0xrphl/Solar-crypto-mining-farm-maximization-control/Miner_solar_cluster_imgs/README.md

# 📸 Project Photo Gallery

All hardware photos, product screenshots, and installation images for the Solar Mining Cluster project.

---

## 🏠 House & Solar Installation

| | |
|---|---|
| House Front | House Isometric |

## ⚡ Distribution Panel & Circuit

| | |
|---|---|
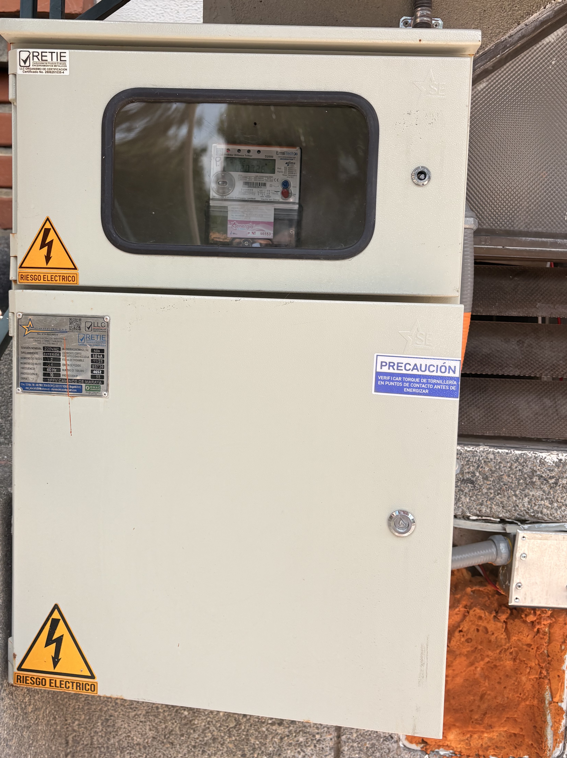
[picture p32: Miner_solar_cluster_imgs/electrical outdoor panel closed.jpeg]
Panel Closed
|  | Panel Open |
| Panel Close-up | Circuit Diagram |
| Hand-drawn Circuit | Item List |

## 🧠 ESP32-S3 Controller (LilyGO T-Display-S3)

| | | |
|---|---|---|
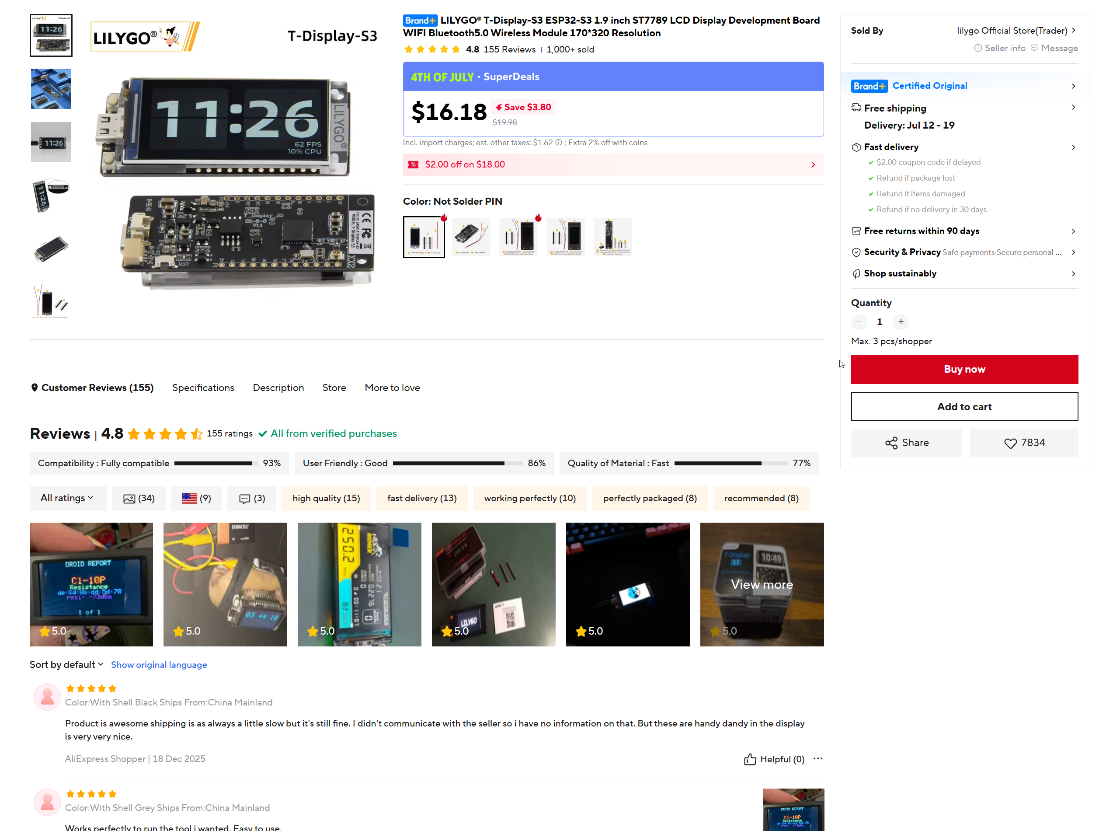
[picture p33: Miner_solar_cluster_imgs/LILYGO T-Display-S3 ESP32-S3 1.9 inch ST7789 aliexpress screenshot.png]
AliExpress
|  | Front | Back |
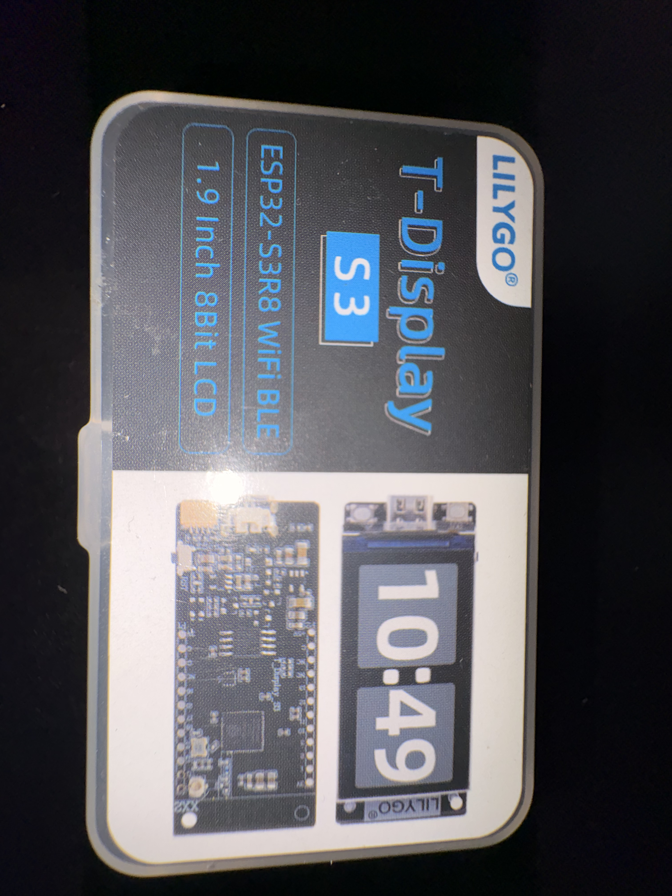
[picture p34: Miner_solar_cluster_imgs/LILYGO® T-Display-S3 ESP32-S3 box front.jpeg]
|  | | |

## 📊 Refoss EM06P Energy Monitor

| | | |
|---|---|---|
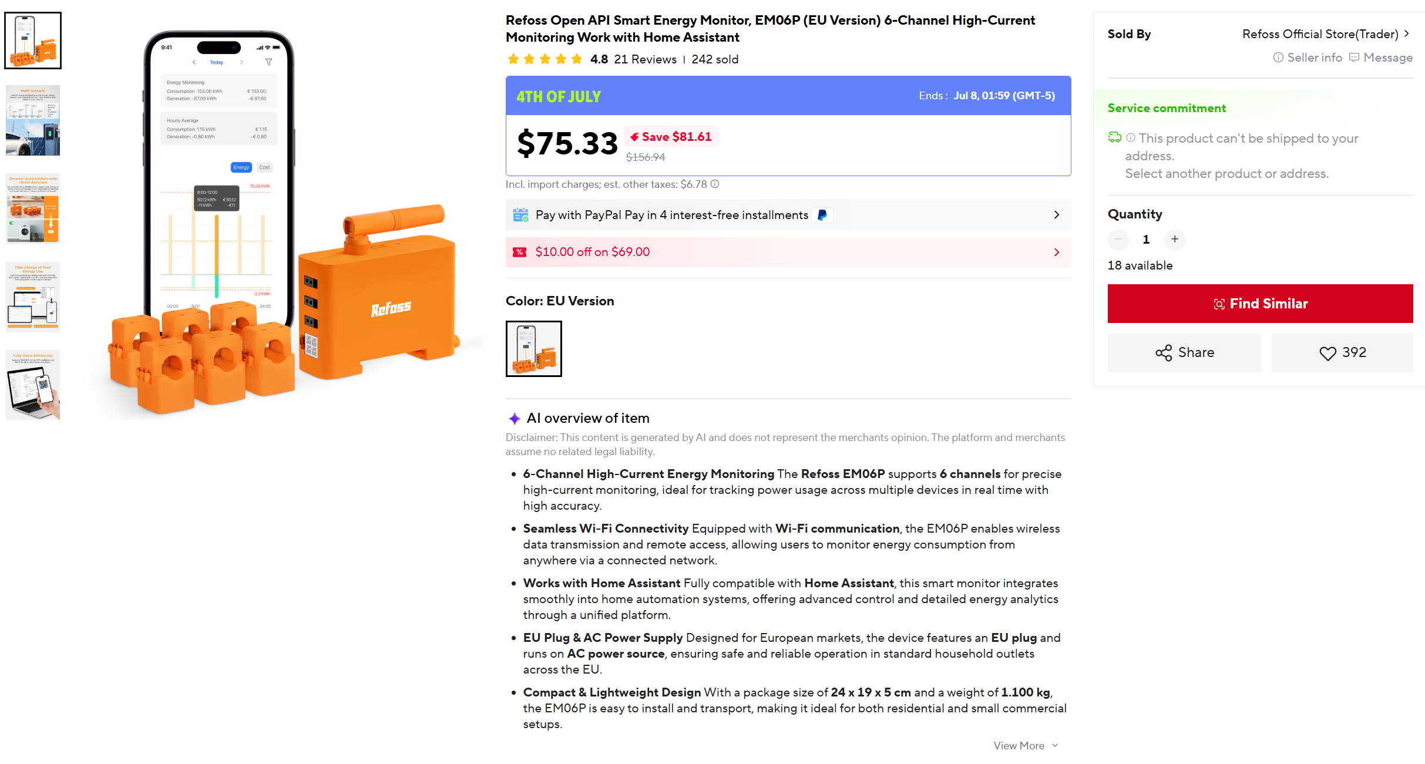
[picture p35: Miner_solar_cluster_imgs/Refoss EM06P 6-Channel WiFi Energy Monitor EU Aliexpress.png]
AliExpress
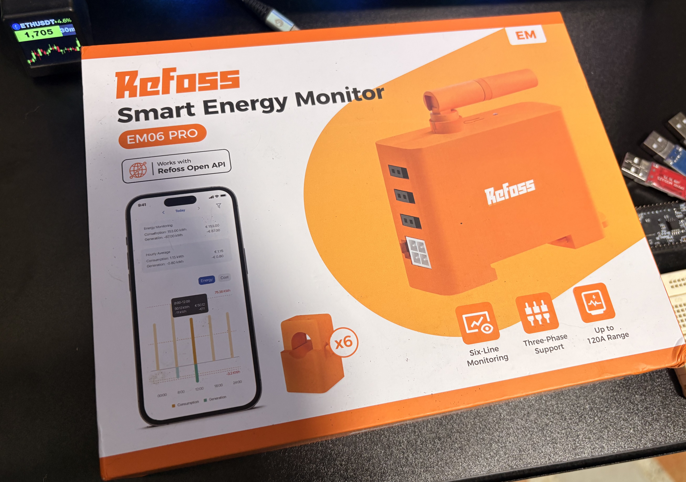
[picture p36: Miner_solar_cluster_imgs/Refoss Open API Smart Energy Monitor, EM06P (EU Version) 6-Channel High-Current Monitoring Work with Home Assistant box.jpeg]
|  |  | Open Box |
| Crimping | Terminals | |

## 🔌 Relay Boards

### ESP32-WROOM 2CH Relay (Active — 192.168.1.78)

| | | |
|---|---|---|
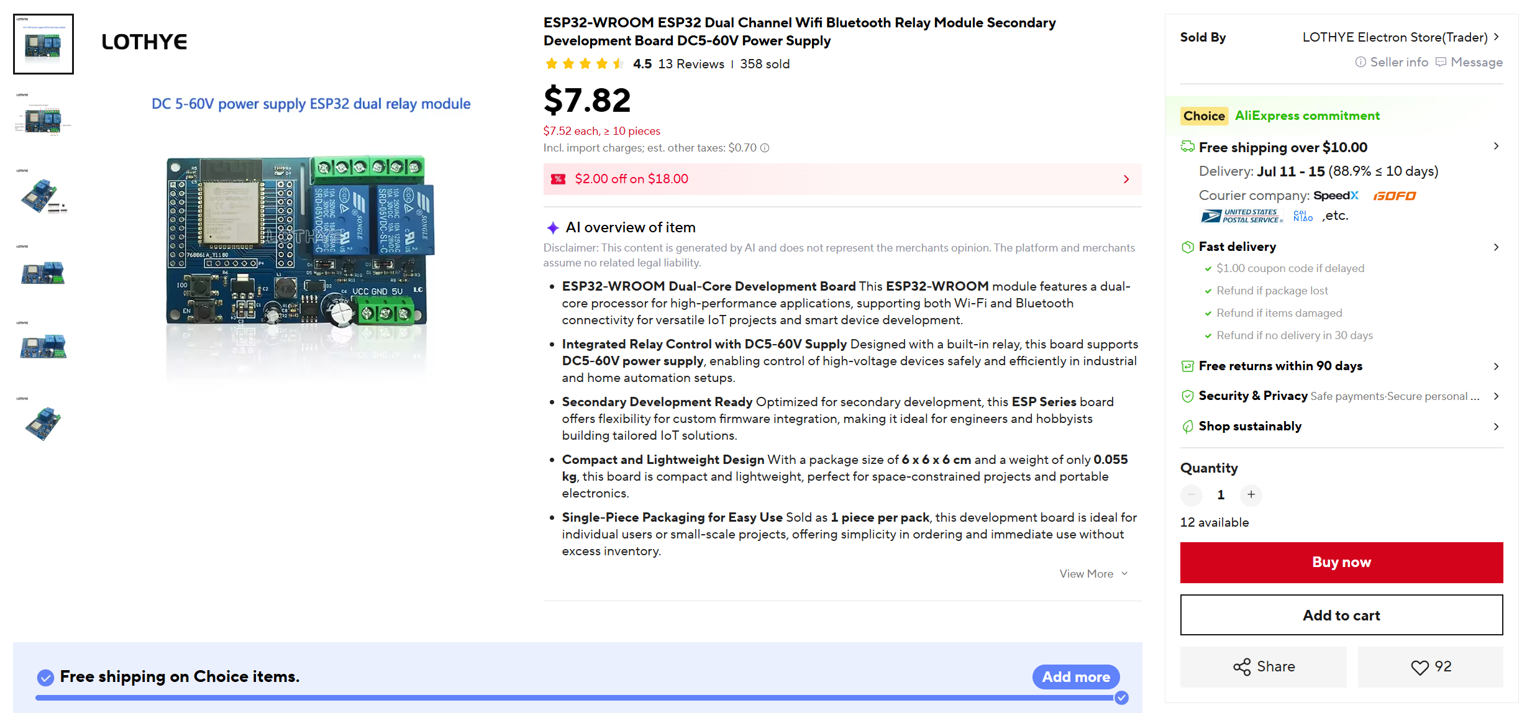
[picture p37: Miner_solar_cluster_imgs/ESP32-WROOM ESP32 Dual Channel Wifi Bluetooth Relay Module Secondary Development Aliexpress.png]
AliExpress
Back
|  | Front |  |
| Installed | Connected | |

### ESP8266 2CH 30A Relay (Backup — 192.168.1.77)

| | |
|---|---|
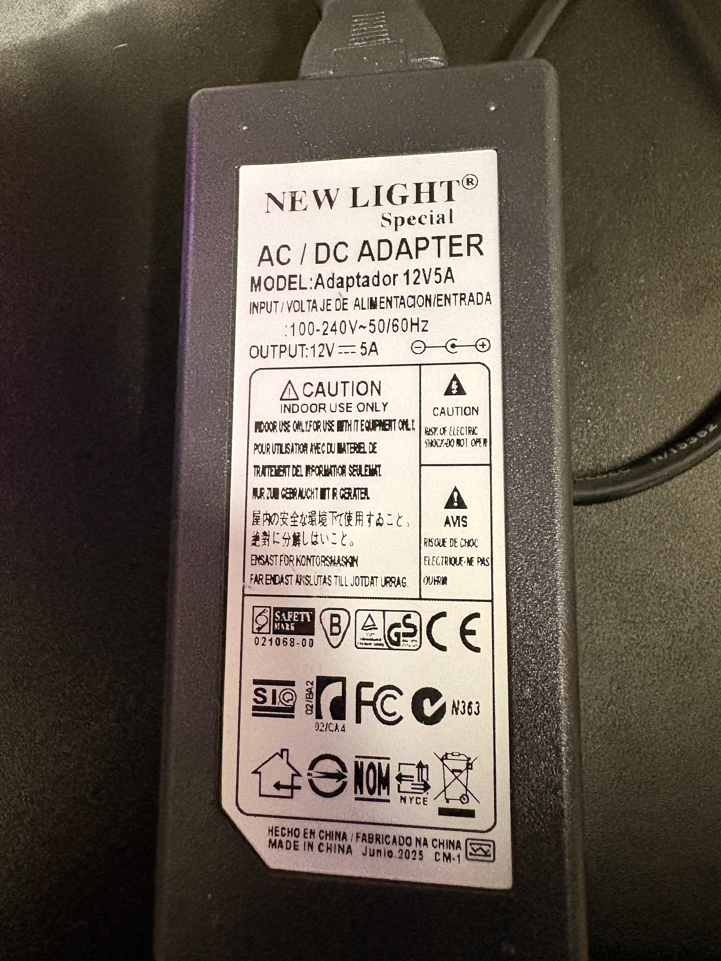
[picture p39: Miner_solar_cluster_imgs/ESP8266 2relay PSU.jpeg]
PSU
| AliExpress |  |

## ⛏️ Mining Hardware

### BitAxe Gamma 601 (1.5 TH/s, 21W)

| | |
|---|---|
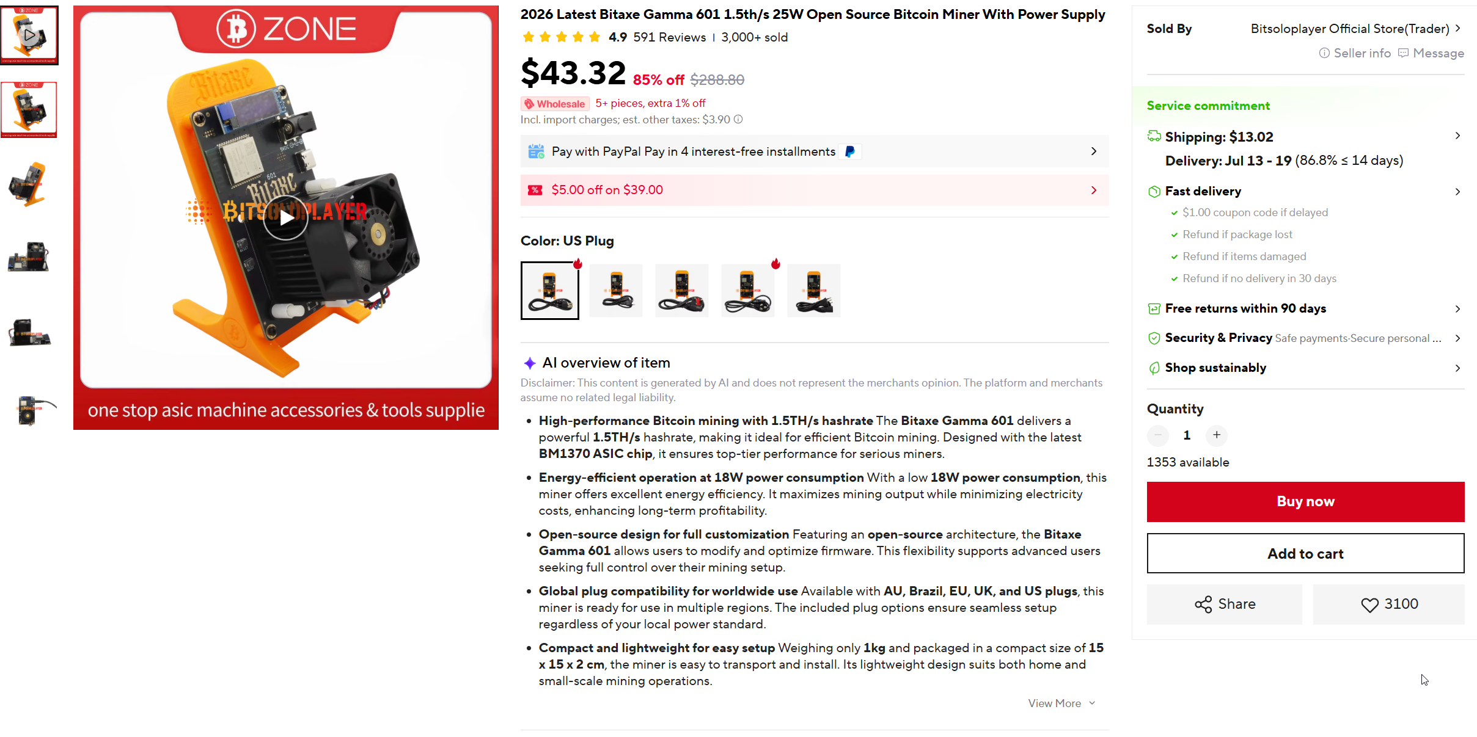
[picture p40: Miner_solar_cluster_imgs/Bitaxe Gamma 601 1.5TH Bitcoin Miner 25W Aliexpress.png]
AliExpress
|  | Front |

### NerdQAxe+ (2.5 TH/s, 60W)

| | |
|---|---|
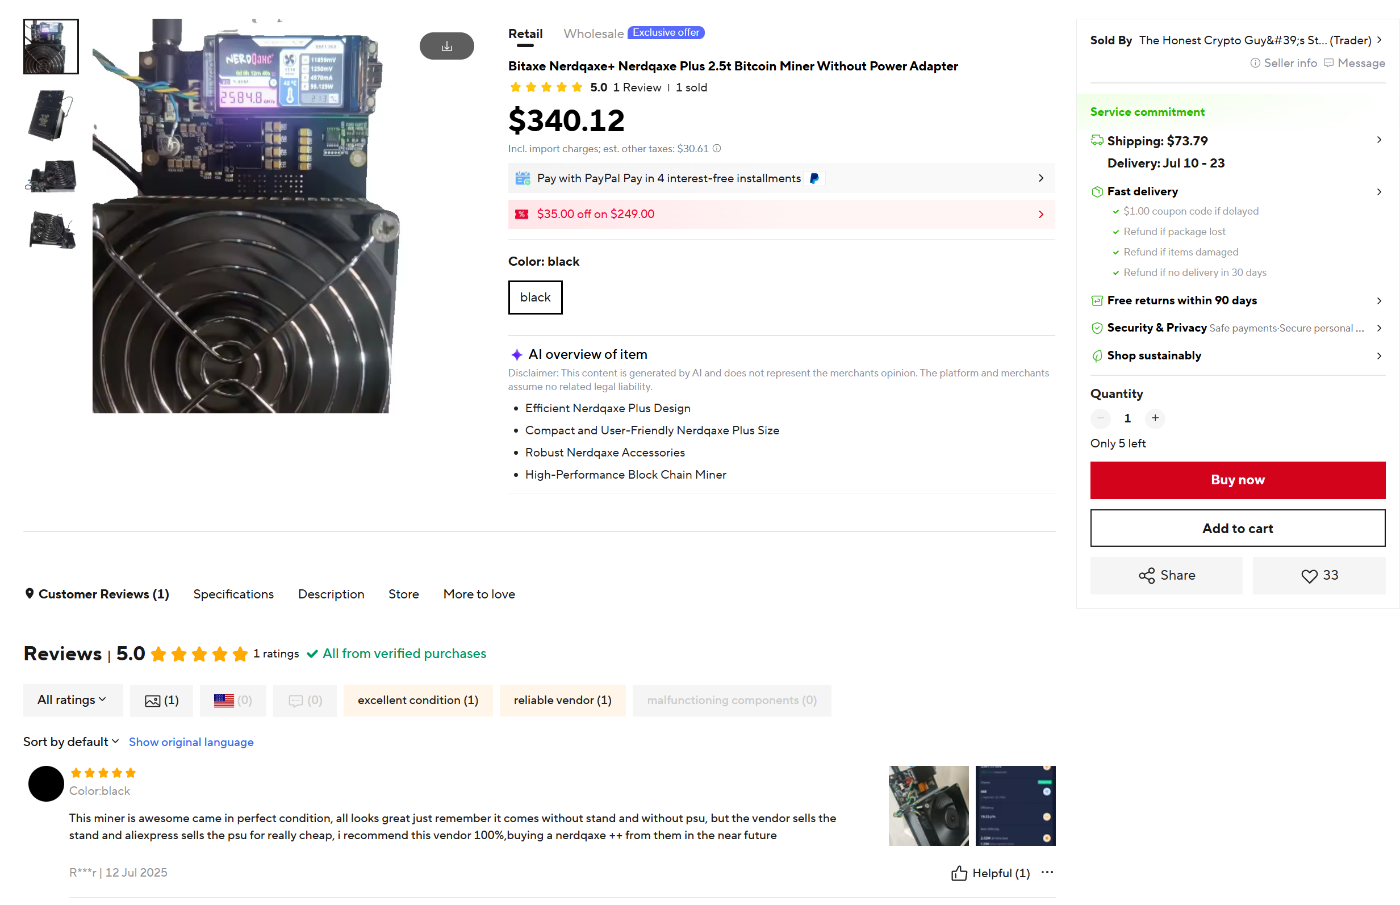
[picture p41: Miner_solar_cluster_imgs/Bitaxe Nerdqaxe+ Nerdqaxe Plus 2.5t Bitcoin Miner Without Power Adapter - AliExpress.png]
AliExpress
|  | Cluster |

### Nerd Octaxe (10.7 TH/s, 180W)

| | | |
|---|---|---|
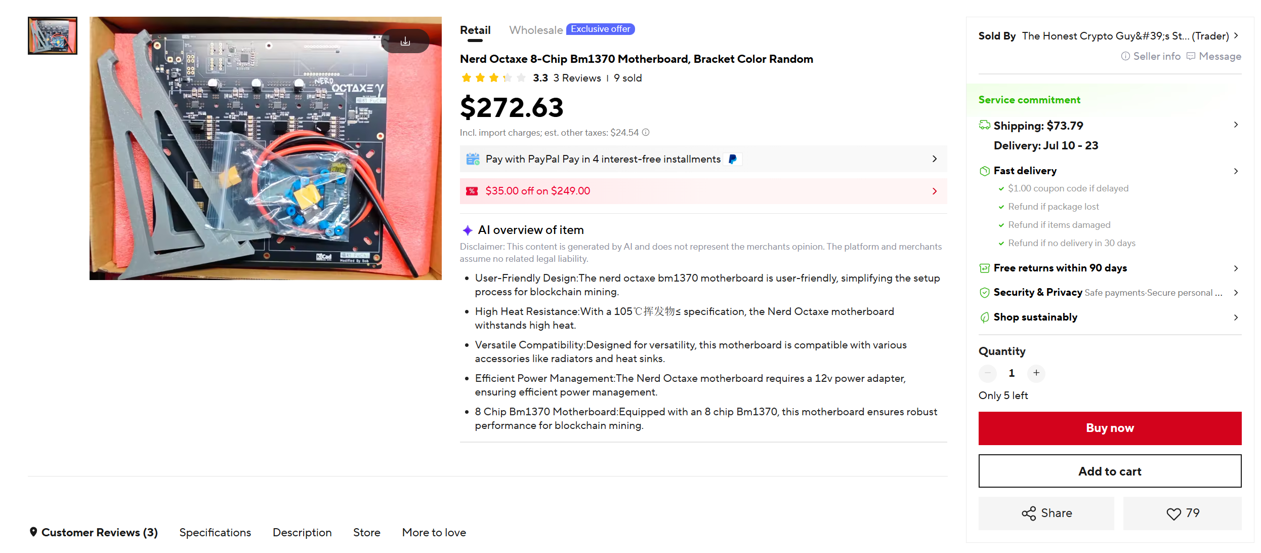
[picture p42: Miner_solar_cluster_imgs/Nerd Octaxe 8-Chip Bm1370 Motherboard, Bracket Color Random - AliExpress.png]
AliExpress
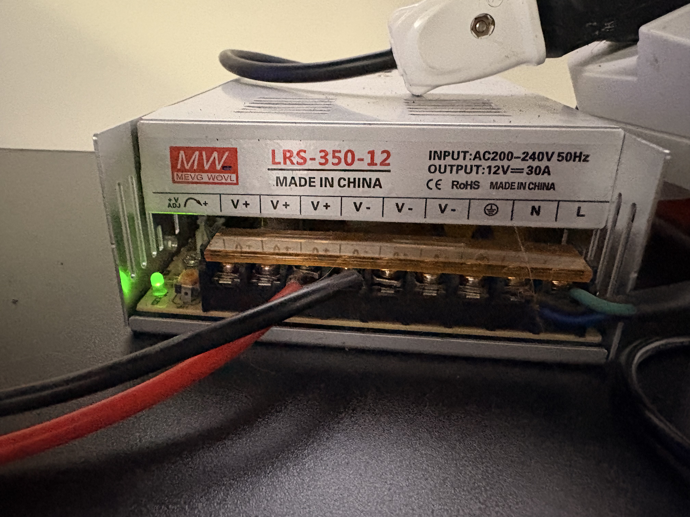
[picture p43: Miner_solar_cluster_imgs/octaxe PSU terminal specs photo.jpeg]
PSU Specs
|  | Front |  |

### Canaan Avalon Q (90 TH/s, 800-1720W)

| | |
|---|---|
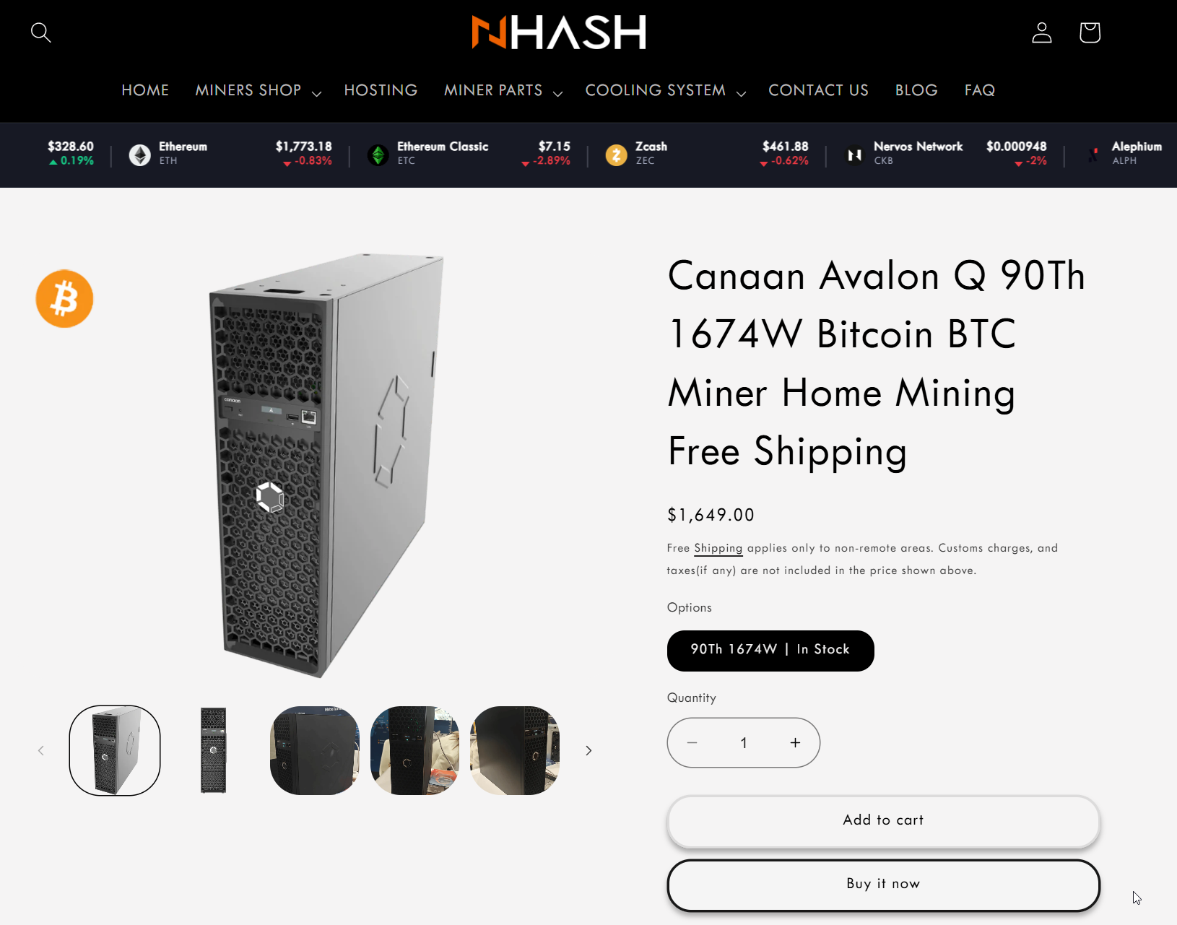
[picture p44: Miner_solar_cluster_imgs/Canaan Avalon Q 90Th 1674W Bitcoin BTC Miner Home Mining Free Shipping - NHASH.png]
NHASH
|  | Front |

### Mining Cluster Assembly

| | | |
|---|---|---|
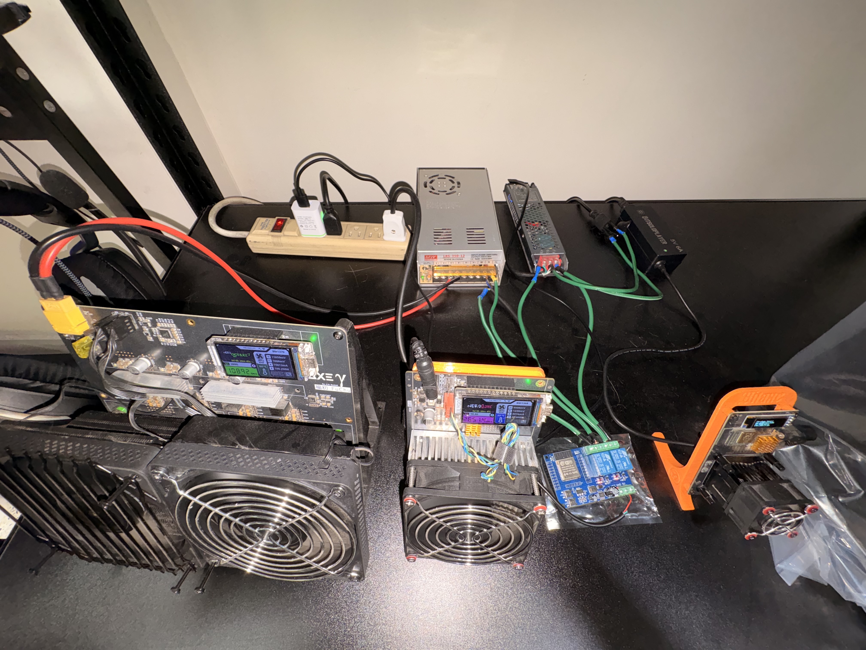
[picture p45: Miner_solar_cluster_imgs/Octaxe nerqaxe and botaxe cluster one photo front up photo.jpeg]
Cluster Up
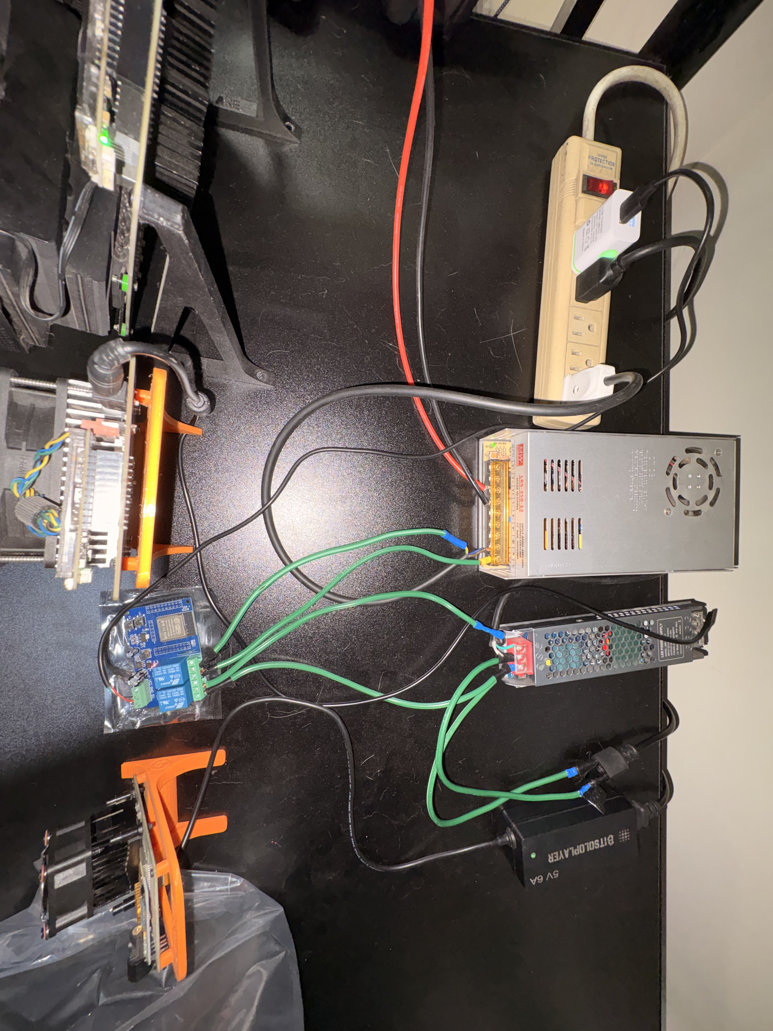
[picture p46: Miner_solar_cluster_imgs/Octaxe nerqaxe and botaxe cluster one photo upper photo.jpeg]
Cluster Upper
| Cluster Front |  |  |
| PSU Connections | PSU Upper | PSU Alt |

## 🔋 Power Supplies

| | | |
|---|---|---|
| 5V/12V PSU | PSU Back | 12V 100W |
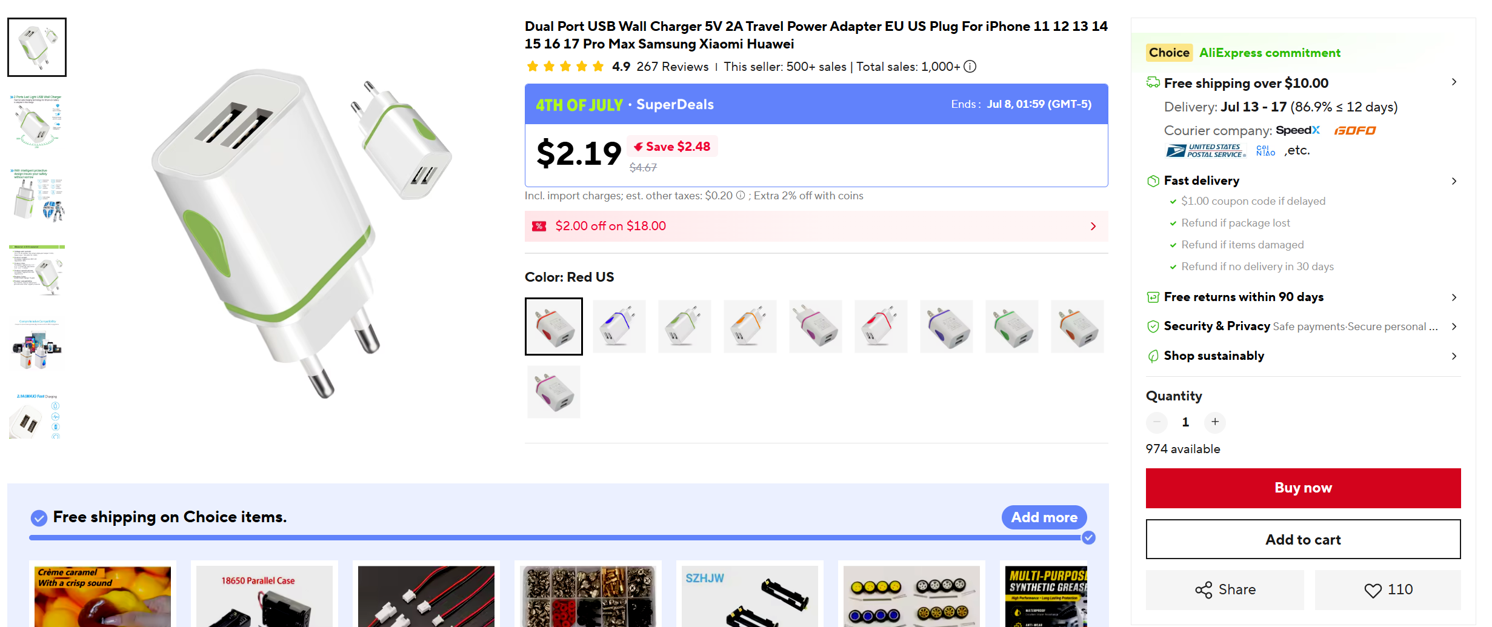
[picture p47: Miner_solar_cluster_imgs/Dual Port USB Wall Charger 5V 2A Travel Power Adapter EU US Plug Aliexpress.png]
USB Charger AliExpress
|  | USB Charger | |

## 🛠️ Tools & Wiring

| | | |
|---|---|---|
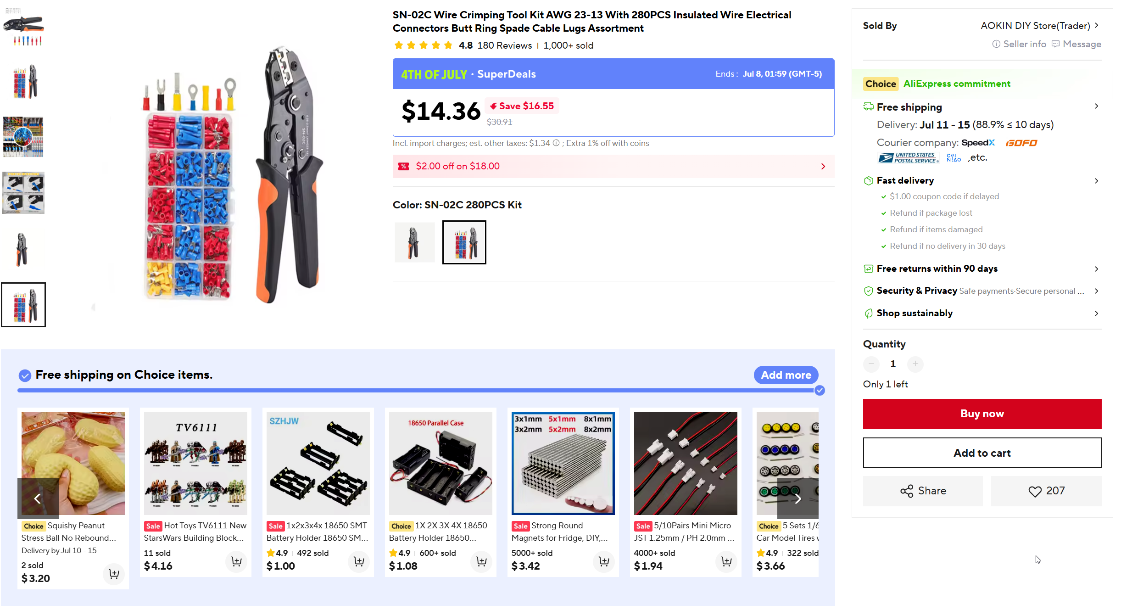
[picture p48: Miner_solar_cluster_imgs/Wire Crimping Tool Kit AWG 23-13 With 280PCS Insulated Wire Aliexpress.png]
Wire Crimper AliExpress
|  | Crimper Photo | Terminal Lugs |
| Wire Stripper | LAOA Pliers | Fan Guards |
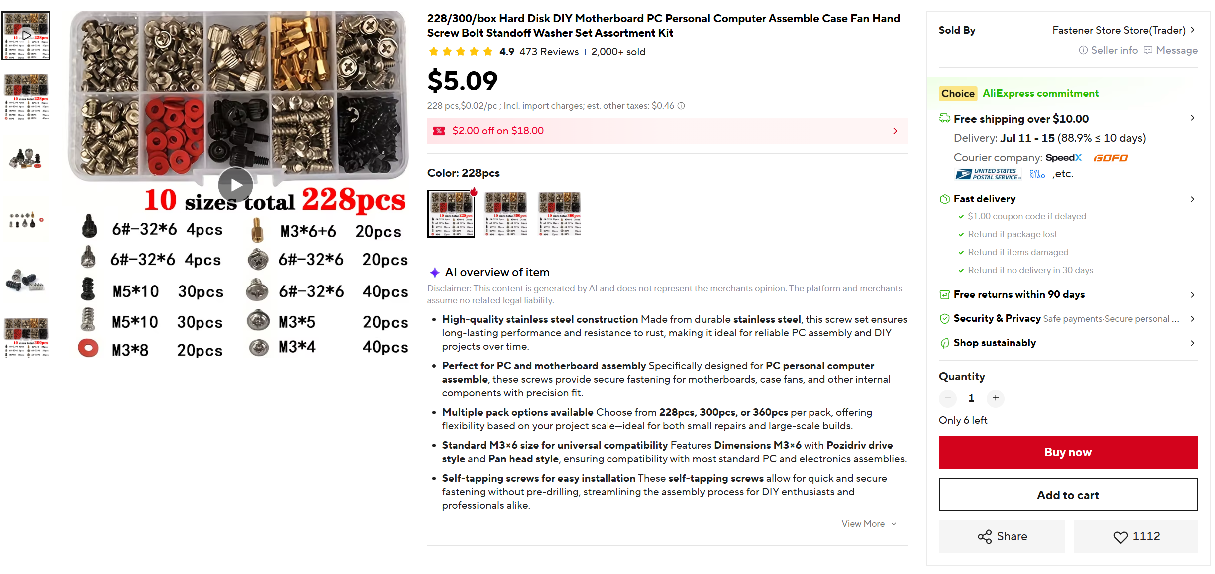
[picture p49: Miner_solar_cluster_imgs/Stainless Steel M36 Pan Head Screw Set 228_300_360pcs.png]
Screw Set
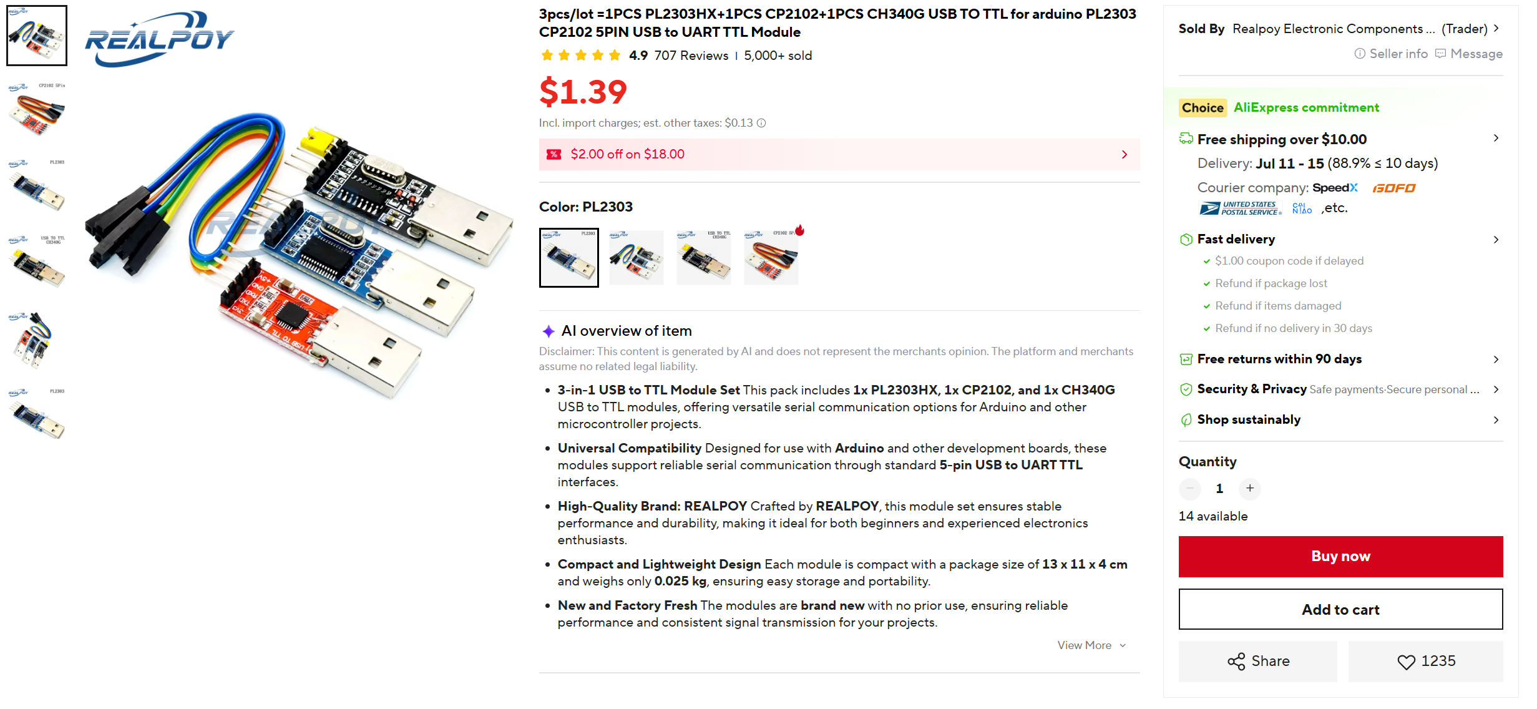
[picture p50: Miner_solar_cluster_imgs/3pcs_lot =1PCS PL2303HX+1PCS CP2102+1PCS CH340G USB TO TTL for arduino PL2303 CP Aliexpress.png]
USB-TTL AliExpress
|  |  | USB-TTL Front |

## 🖥️ ESP32 Web Dashboard (v4)

| | |
|---|---|
| Dashboard Full | Dashboard Zoom |

## �️ Dashboard Product Images

| | | | |
|---|---|---|---|
| BitAxe | NerdQAxe | Octaxe | Avalon Q |
| Solar Panel | | | |
