0xrphl/Solar-crypto-mining-farm-maximization-control/Miner_solar_cluster_imgs/aliexpress_items_list.txt

LILYGO® T-Display-S3 ESP32-S3 1.9 inch ST7789 LCD Display Development Board WIFI Bluetooth5.0 Wireless Module 170*320 Resolution
https://www.aliexpress.us/item/3256804310228562.html?channel=twinner

DC 12V 24V Switching Power Supply AC110-250V Mute Lighting Transformers 60W 100W 200W 300W 400W LED Light Driver Power Adapter
https://www.aliexpress.us/item/3256807208787904.html?channel=twinner 

Bitaxe Nerdqaxe+ Nerdqaxe Plus 2.5t Bitcoin Miner Without Power Adapter
https://www.aliexpress.us/item/3256808693446062.html?channel=twinner 

2026 Latest Bitaxe Gamma 601 1.5th/s 25W Open Source Bitcoin Miner With Power Supply
https://www.aliexpress.us/item/3256808067170426.html?channel=twinner 

Automatic Stripping Cutter Wire Stripper Pliers Cable Wire Crimping Electrician Repair Tools Wire Stripper Tool hand tools
https://www.aliexpress.us/item/3256808741160255.html?channel=twinner 

LAOA Multifunctional Fast Fully Automatic Wire Stripping Pliers Cable Cutting Nippers Adjustable Electrician Pliers
https://www.aliexpress.us/item/3256807032671463.html?channel=twinner 

SN-02C Wire Crimping Tool Kit AWG 23-13 With 280PCS Insulated Wire Electrical Connectors Butt Ring Spade Cable Lugs Assortment
https://www.aliexpress.us/item/3256810332001270.html?channel=twinner 

ESP32-WROOM ESP32 Dual Channel Wifi Bluetooth Relay Module Secondary Development Board DC5-60V Power Supply
https://www.aliexpress.us/item/3256804243304840.html?channel=twinner 

Refoss Open API Smart Energy Monitor, EM06P (EU Version) 6-Channel High-Current Monitoring Work with Home Assistant
https://www.aliexpress.us/item/3256809503697509.html?channel=twinner 

2 Channel ESP8266 WIFI Relay Module ESP-12F Development Board Module 30A For Smart Home Wireless Control DC7-28/5V DC7-80/5V
https://www.aliexpress.us/item/3256802365448988.html?channel=twinner 

3pcs/lot =1PCS PL2303HX+1PCS CP2102+1PCS CH340G USB TO TTL for arduino PL2303 CP2102 5PIN USB to UART TTL Module
https://www.aliexpress.us/item/3256806910315665.html?channel=twinner

150pcs/set Round Terminal Block DJ431 O-type Lugs Terminals Cold-Pressed Connector Copper Tab Wiring Nose Combination Set New
https://www.aliexpress.us/item/3256806062864141.html?channel=twinner 

Cooling Fan Guard Metal Grill Computer Cover Fan Grill 30mm 40mm 50mm 60mm 70mm 80mm 90mm 120mm 135mm 140mm 170mm 200mm
https://www.aliexpress.us/item/3256805281155490.html?channel=twinner

228/300/box Hard Disk DIY Motherboard PC Personal Computer Assemble Case Fan Hand Screw Bolt Standoff Washer Set Assortment Kit
https://www.aliexpress.us/item/3256807755286435.html?channel=twinner 

Nerd Octaxe 8-Chip Bm1370 Motherboard, Bracket Color Random - AliExpress
https://www.aliexpress.us/item/3256808957009912.html?channel=twinner 

Canaan Avalon Q 90Th 1674W Bitcoin BTC Miner Home Mining
https://nhash.net/products/canaan-avalon-q-90th-1674w-bitcoin-btc-miner-free-shipping

Dual Port USB Wall Charger 5V 2A Travel Power Adapter EU US Plug 
https://www.aliexpress.us/item/3256808314505260.html?channel=twinner
