0xrphl/Solar-crypto-mining-farm-maximization-control/(commit log)

2026-07-05 Initial commit: Solar Mining Cluster - ESP32 autonomous Bitcoin mining with solar surplus
2026-07-05 Comprehensive README with photos BOM solar array specs mining profiles and architecture diagrams
2026-07-05 Fix: Solar formula uses abs on both CT clamps for direction independence
    [MinerControl_WebUI_FINAL.ino]
2026-07-05 Add image gallery README cable cutter photos move hero image after How It Works
2026-07-05 Move circuit diagram below How It Works keep isometric pair at top
2026-07-05 Swap images: circuit diagram at top isometric house under How It Works
2026-07-05 Fix Avalon Q status detection: query actual hashrate+WORKMODE instead of TCP ping persist miningState to NVS boot-time reconciliation verify all miners with power+hashrate
    [MinerControl_WebUI_FINAL.ino]
2026-07-05 Extend decision cycle to 10 min Avalon Q needs 5-8 min to ramp hashrate increase sample buffer to 24
2026-07-05 Split-timing: relays decide every 5min Avalon every 10min Supabase push every 5min recency-weighted grid avg
2026-07-05 Fix Avalon Q standby detection: SoftOFF>0 not ==1 STATE!=1 not ==0 add 30s cooldown reverse verify/decision order skip redundant commands
    [MinerControl_WebUI_FINAL.ino]
2026-07-06 Fix SoftOFF is sticky counter: cross-check with STATE=1 and GHSavg>100 before declaring sleep prevents false standby detection when Avalon is actively mining
    [MinerControl_WebUI_FINAL.ino]
2026-07-06 Critical fix: relay-only 5min cycle was killing Avalon by falling to S0 when no same-mode profile fits surplus. Also fix cooldown blocking workmode after wakeup.
    [MinerControl_WebUI_FINAL.ino]
2026-07-09 Add ESP32 web dashboard v4 screenshots to README and images gallery
