0xrphl/Solar-crypto-mining-farm-maximization-control/Miner_solar_cluster_imgs/ESP32-WROOM ESP32 Dual Channel Wifi Bluetooth Relay Module Secondary Development back.jpeg

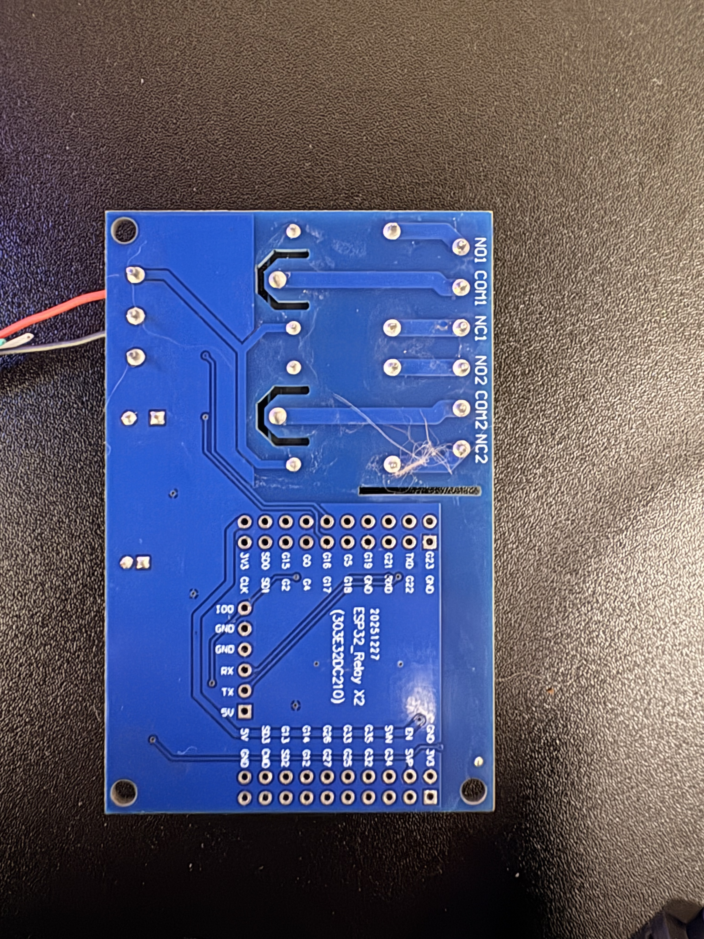
[picture p38: Miner_solar_cluster_imgs/ESP32-WROOM ESP32 Dual Channel Wifi Bluetooth Relay Module Secondary Development back.jpeg]
Miner_solar_cluster_imgs/ESP32-WROOM ESP32 Dual Channel Wifi Bluetooth Relay Module Secondary Development back.jpeg
