0xrphl/Solar-crypto-mining-farm-maximization-control/Miner_solar_cluster_imgs/Dual Port USB Wall Charger 5V 2A Travel Power Adapter.jpeg

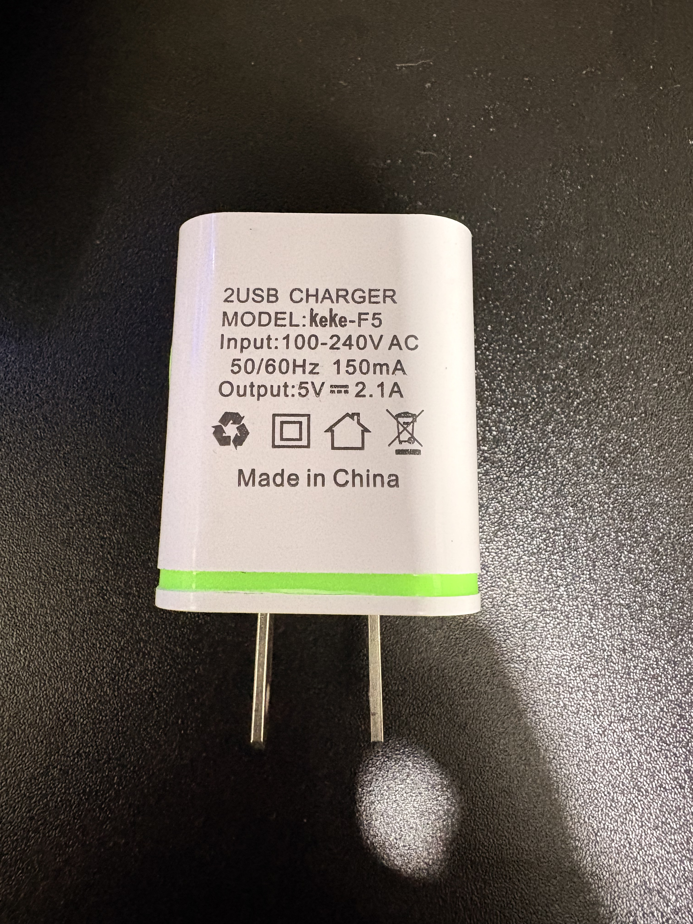
[picture p26: Miner_solar_cluster_imgs/Dual Port USB Wall Charger 5V 2A Travel Power Adapter.jpeg]
Miner_solar_cluster_imgs/Dual Port USB Wall Charger 5V 2A Travel Power Adapter.jpeg
